BadgePiratesLLC/DefCon_SecKC_26/Tutorials/README.md

# Badge Pirates DC26 Badge Tutorials

Our badge (while blingy) is designed for hacking.  The add-on development board gives you access to the pins
of the ESP32 MCU as well as power.  The idea is for you to take and extend the badge to do something even more
interesting.
# How to Program the DC26 Badge
[Program SecKCDC26 Badge](/Tutorials/Programming/README.md)

## Examples

We are providing several tutorials and examples for different hacks that we have done using the badge.  These
should give you a good starting point to build on and make it yours!

### LiPo Battery Extension

The stock badge comes with a 2x AAA battery holder which will power the badge for about 8 hours of full
bling.  If you want to turn on the wireless features, it draws down the battery much quicker.  @fg has
done a hack to add a LiPo and charger to his badge to give you an idea of how to do this.

[LiPO Battery Tutorial](/Tutorials/Lipo/README.md)

### Cotcha Stand Alone Badge

Maybe you didn't buy a badge and got just a DEV board, or want to build a badge of your own.  @networkgeek took
the components from a SECKC Cotcha designed by @billswearingen and made a completely stand alone badge.

[SecKC Cotcha Tutorial](/Tutorials/Cotcha/README.md)

### SecKC the World Party Standalone

Were you one of the supporters for the very first (offical) [SecKC](www.seckc.org) Defcon Party?  There were some additional things
about the SAO that you might not have known.

[SecKC the World SAO](/Tutorials/SecKCSAO/README.md)

## Authors

* **networkgeek** - [Carl Fugate](www.twitter.com/carlfugate)
* **fg** - [Kevin Bennett](www.twitter.com/flightgod)

## License

This project is licensed under the MIT License - see the [LICENSE.md](LICENSE.md) file for details

## Acknowledgments

* CodexMafia for his second year in helping us put badges together
* Bill Swearingen for the AWESOME SECKC Cotcha
* The entire #badgelife team for their support in helping us to become fellow badgemakers
