BadgePiratesLLC/DefCon_SecKC_26/Coin/1.png

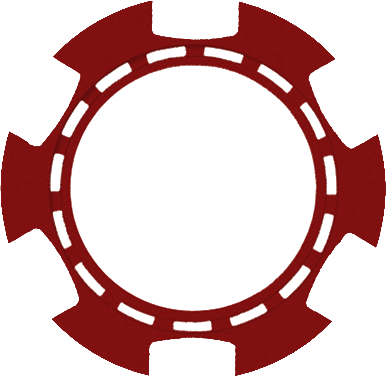
Coin/1.png
