BadgePiratesLLC/DefCon_SecKC_26/Coin/2.png

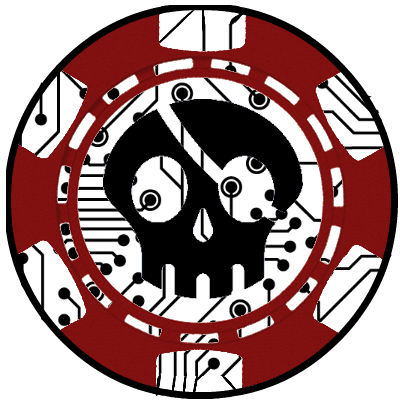
Coin/2.png
