BadgePiratesLLC/DefCon_SecKC_26/Coin/231RD.png

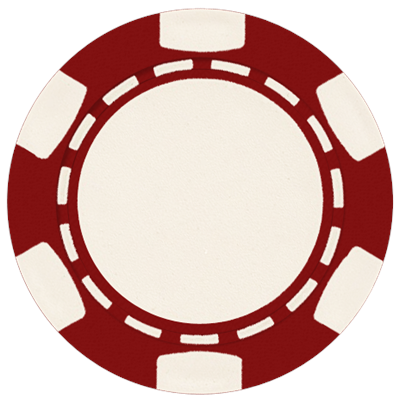
Coin/231RD.png
