BadgePiratesLLC/DefCon_SecKC_26/Coin/BP@DC.png

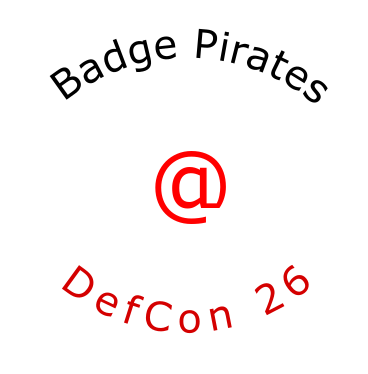
Coin/BP@DC.png
