BadgePiratesLLC/DefCon_SecKC_26/Coin/BPSkull_Black.png

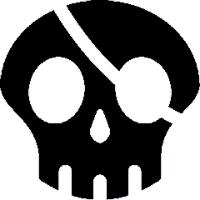
Coin/BPSkull_Black.png
