BadgePiratesLLC/DefCon_SecKC_26/Coin/chiop.png

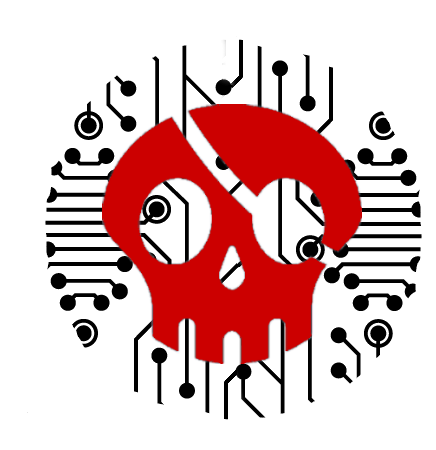
Coin/chiop.png
