BadgePiratesLLC/DefCon_SecKC_26/Coin/ChipGold.png

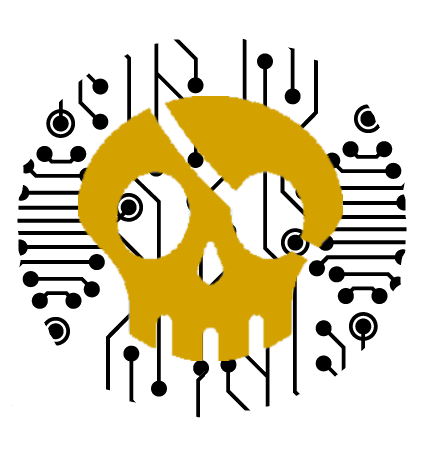
Coin/ChipGold.png
