BadgePiratesLLC/DefCon_SecKC_26/Coin/ChipGray.png

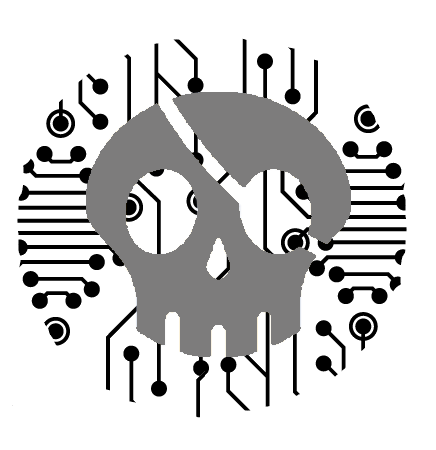
Coin/ChipGray.png
