BadgePiratesLLC/DefCon_SecKC_26/Coin/drawing-1.png

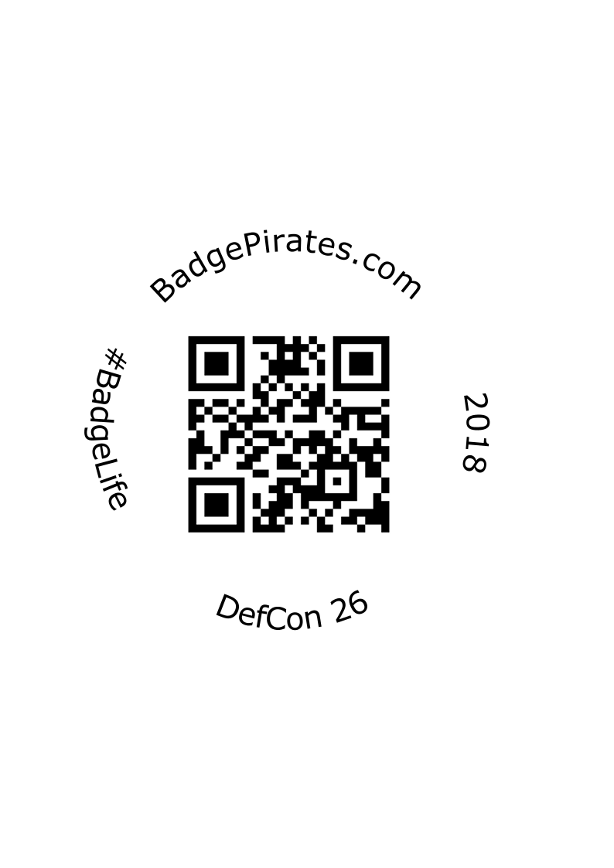
Coin/drawing-1.png
