BadgePiratesLLC/DefCon_SecKC_26/Coin/images.png

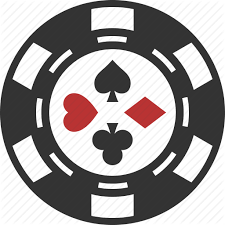
Coin/images.png
