BadgePiratesLLC/DefCon_SecKC_26/Coin/Outline1.png

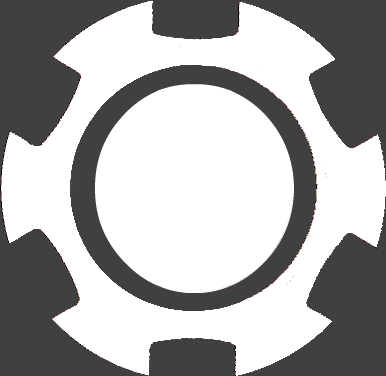
Coin/Outline1.png
