BadgePiratesLLC/DefCon_SecKC_26/Coin/Outline.png

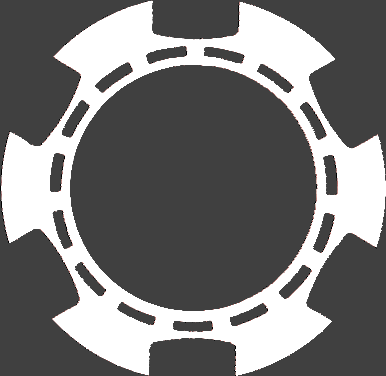
Coin/Outline.png
