BadgePiratesLLC/DefCon_SecKC_26/Coin/PCD01_Red.jpg

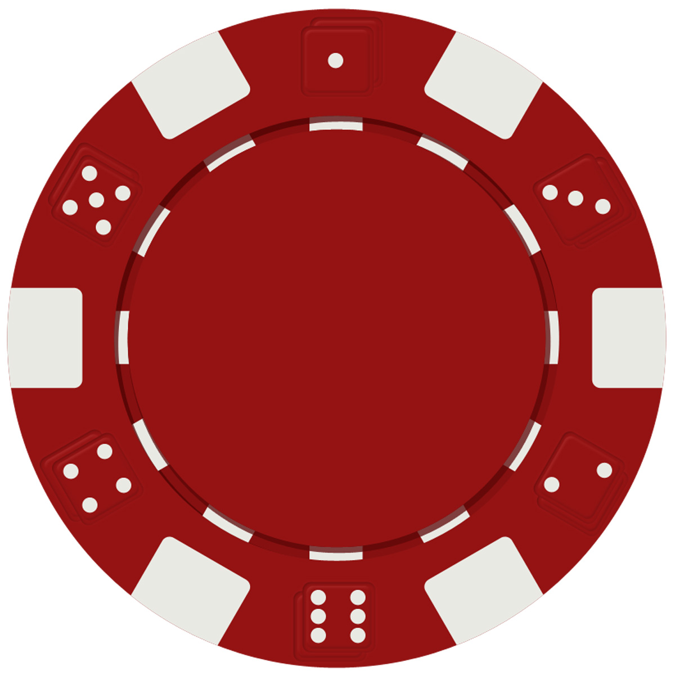
Coin/PCD01_Red.jpg
