BadgePiratesLLC/DefCon_SecKC_26/Coin/traces1.png

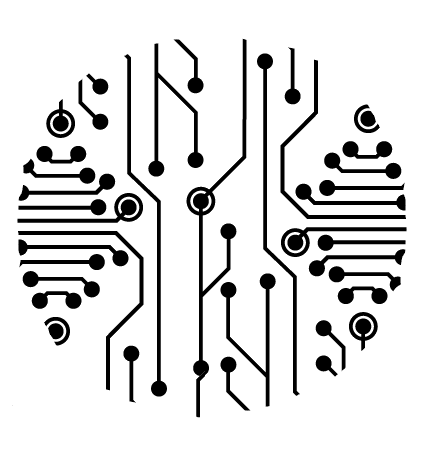
Coin/traces1.png
