BadgePiratesLLC/DefCon_SecKC_26/Coin/traces.png

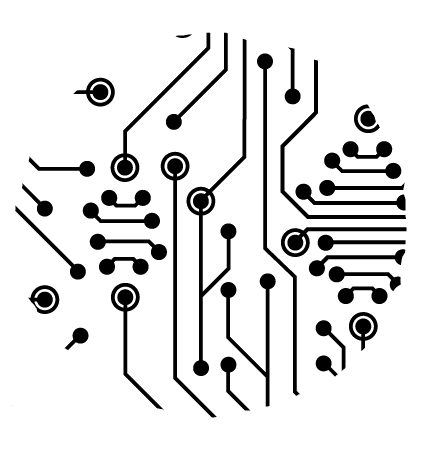
Coin/traces.png
