BadgePiratesLLC/DefCon_SecKC_26/Photos/Capture.JPG

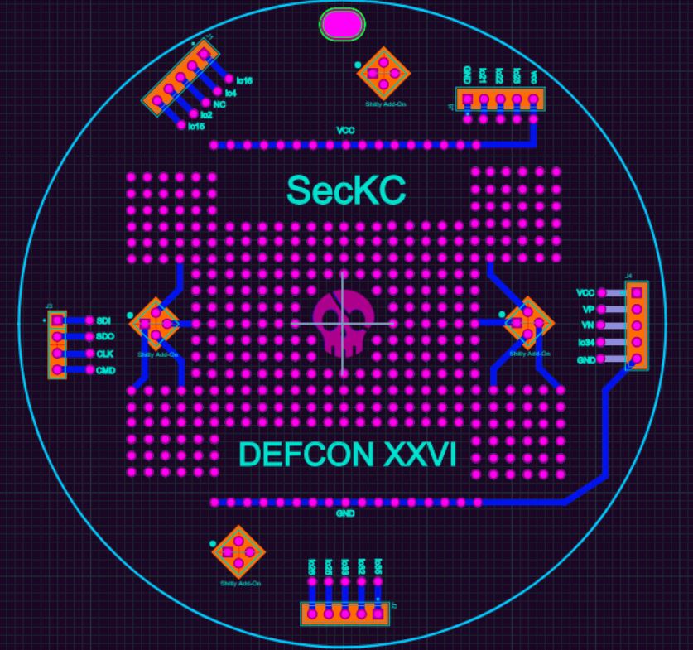
Photos/Capture.JPG
