BadgePiratesLLC/DefCon_SecKC_26/Photos/Capture.PNG

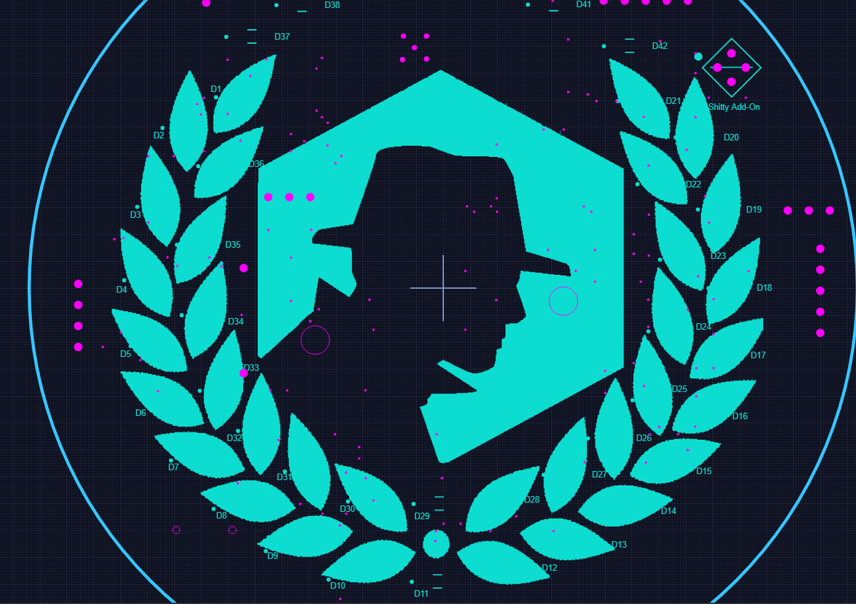
Photos/Capture.PNG
