BadgePiratesLLC/DefCon_SecKC_26/Photos/chipGold.png

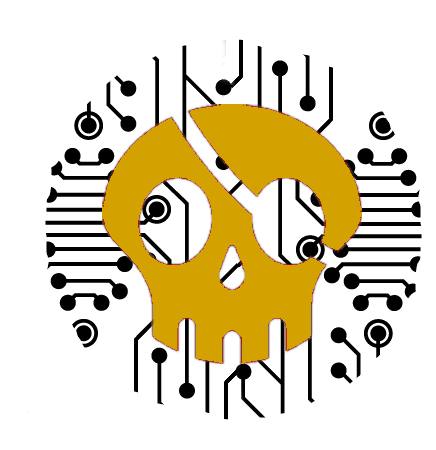
Photos/chipGold.png
