BadgePiratesLLC/DefCon_SecKC_26/Photos/IMG_3219.JPG

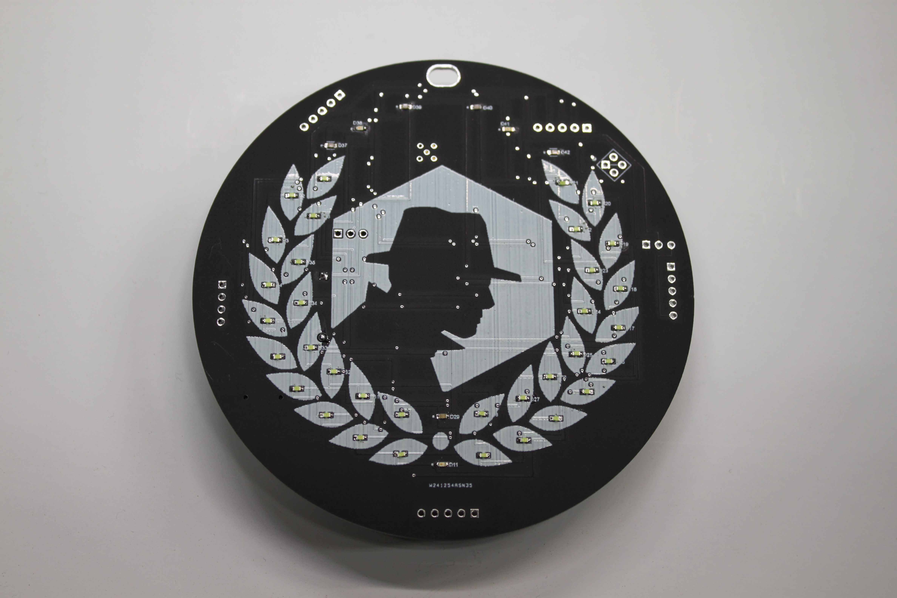
Photos/IMG_3219.JPG
