BadgePiratesLLC/DefCon_SecKC_26/Photos/SECKC Bob Shitty Addon.png

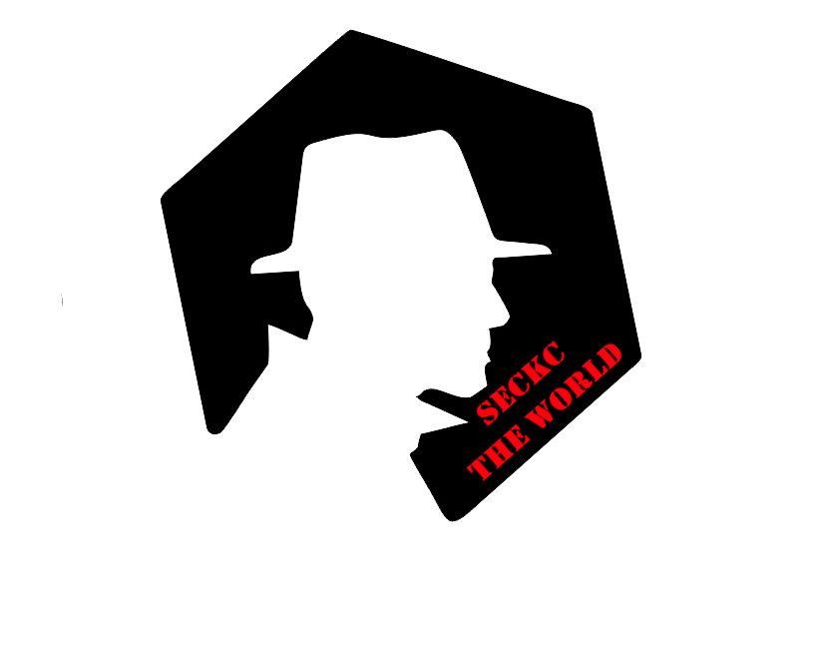
Photos/SECKC Bob Shitty Addon.png
