BadgePiratesLLC/DefCon_SecKC_26/Photos/SECKC Bob with wreath.png

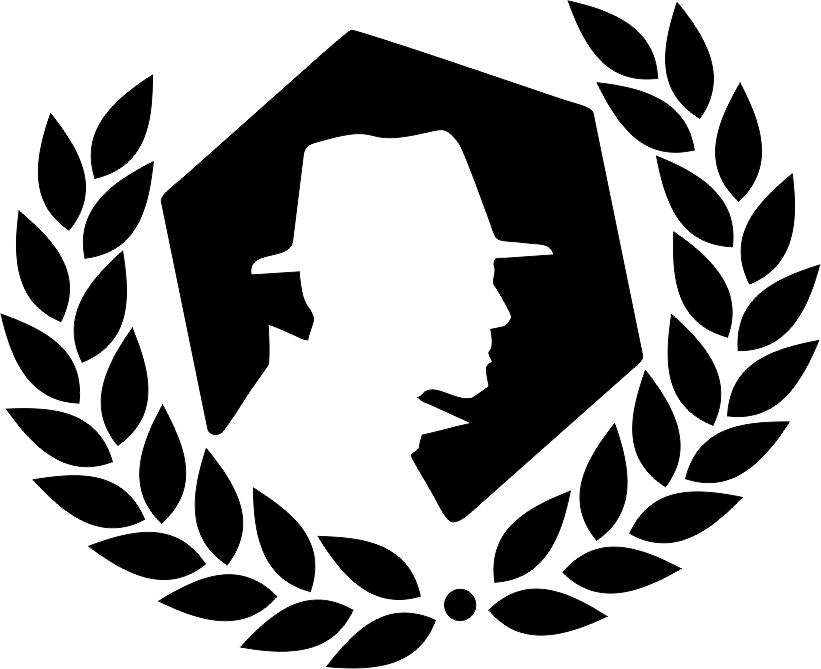
Photos/SECKC Bob with wreath.png
