BadgePiratesLLC/DefCon_SecKC_26/Photos/SECKC wreath.png

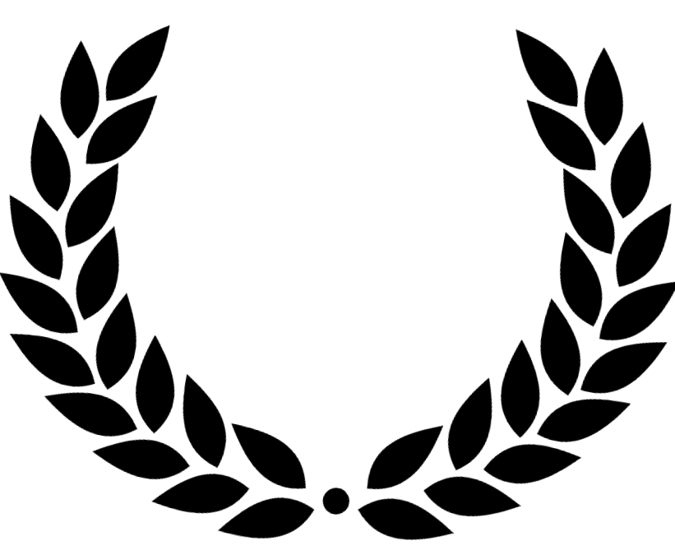
Photos/SECKC wreath.png
