BadgePiratesLLC/DefCon_SecKC_26/BadgePirates_SecKC_DC26Badge_BOM.xlsx

Reference Designator | Description | Manufacturer | Manufacturer Part Number | Package | Quantity | Mouser Part Number | Digikey Description | Digikey Part Number | URL | Price
2 AAA | PC BATTERY HOLDER (2) 'AAA' | Keystone | 2468 | BAT_HOLDER | 1 | 534-2468 | HOLDER BATTERY 2CELL AAA PC MNT | 36-2468-ND | https://www.digikey.com/en/products/detail/keystone-electronics/2468/303817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 | $1.29
Button 0 Reset | 6mm Tact Switch, Straight Termination, 160 grams actuation force | C&K | PTS645SM43SMTR92 LFS | SW_SMT_6MM0_6MM0_TACT | 2 | 611-PTS645SM43SMTR92 | Tactile Switch SPST-NO Top Actuated Surface Mount | CKN9112CT-ND | https://www.digikey.com/en/products/detail/c-k/PTS645SM43SMTR92-LFS/1146840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 | $0.30
C1 C11 | 0.1ÂµF Â±10% 10V Ceramic Capacitor X7R 0603 (1608 Metric) | Kemet | C0603C104K8RACTU | 603 | 2 | 80-C0603C104K8R | CAP CER 0.1UF 10V X7R 0603 | 399-1095-1-ND | https://www.digikey.com/en/products/detail/kemet/C0603C104K8RAC7867/411094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 | $0.11
C10 | 220ÂµF 6.3V Aluminum Electrolytic Capacitors Radial, Can - SMD 1000 Hrs @ 105Â°C | Panasonic | EEE-HA0J221WP | RADIAL | 1 | 667-EEE-HA0J221WP | CAP ALUM 220UF 20% 6.3V SMD | PCE4161CT-ND | https://www.digikey.com/en/products/detail/panasonic-electronic-components/EEE-HA0J221WP/814133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 | $0.45
D1 D10 D12 D13 D14 D15 D16 D17 D18 D19 D2 D20 D21 D22 D23 D24 D25 D26 D27 D28 D3 D30 D31 D32 D33 D34 D35 D36 D4 D5 D6 D7 D8 D9 | SML-E1 SERIES | ROHM | SMLE12WBC7W1 | 603 | 34 | 755-SMLE12WBC7W1 | LED WHITE DIFFUSED 0603 SMD | 511-1602-2-ND | https://www.digikey.com/en/products/detail/rohm-semiconductor/SMLEN3WBC8W1/9448228 | $0.52
D11 D38 D41 | Blue 470nm LED Indication - Discrete 2.8V 0603 (1608 Metric) | Lite-On Inc. | LTST-C193TBKT-5A | 603 | 3 | 859-LTSTC193TBKT5A | LED BLUE CLEAR 0603 SMD | 160-1827-1-ND | https://www.digikey.com/en/products/detail/liteon/LTST-C193TBKT-5A/2053656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 | $0.28
D29 D39 D40 | EXCELEDâ„¢ series chip LED | ROHM | SML-D12V8WT86 | 0603 (1608 metric) | 3 | 755-SML-D12V8WT86 | LED RED DIFFUSED 0603 SMD | 511-1581-1-ND | https://www.digikey.com/en/products/detail/rohm-semiconductor/SML-D12V8WT86/1641800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 | $0.36
D37 D42 | Standard LEDs - SMD SMD Yellow/Green 10-63 mcd | ROHM | SML-D12M8WT86 | 0603 (1608 metric) | 2 | 755-SML-D12M8WT86 | LED GREEN DIFFUSED 0603 SMD | 511-1578-1-ND | https://www.digikey.com/en/products/detail/rohm-semiconductor/SML-D12M8WT86/1641797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 | $0.32
Power | Sub-Miniature Slide Switch - RIGHT ANGLE SURFACE MOUNT SPDT | C&K | JS102011SAQN | SMT_SWITCH_9MM_3.6MM | 1 | 611-JS102011SAQN | Slide Switch SPDT Surface Mount, Right Angle | 401-1999-1-ND | https://www.digikey.com/en/products/detail/c-k/JS102011SAQN/1640095?s=N4IgTCBcDaICwAYCMBaJBOTaUDkAiIAugL5A | $0.71
R1 R2 R3 R4 R5 R6 R7 | GENERAL PURPOSE CHIP RESISTORS | YAGEO | RC1206JR-07220RL | 1206 (3216 metric) | 7 | 603-RC1206JR-07220RL | RES SMD 220 OHM 5% 1/4W 1206 | 311-220ERCT-ND | https://www.digikey.com/en/products/detail/yageo/RC1206JR-07220RL/729251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 | $0.10
R18 | GENERAL PURPOSE CHIP RESISTORS | YAGEO | RC0603FR-0710KL | 603 | 1 | 603-RC0603FR-0710KL | RES SMD 10K OHM 1% 1/10W 0603 | 311-10.0KHRCT-ND | https://www.digikey.com/en/products/detail/yageo/RC0603FR-0710KL/726880 | $0.10
U112 | WIFI module | Espressif | ESP-WROOM-32 | MOD_SMT | 1 | 485-3320 | SPRESSIF ESP32 BLUETOOTH WIFI M | 1188-1178-ND | https://www.mouser.com/ProductDetail/Adafruit/3320?qs=JnzaLlyswt4EqYFFVW2Law%3D%3D | $7.83
