BadgePiratesLLC/DefCon_SecKC_26/(list of files, cad)

Other CAD files:
Coin/BPSkull_Black.dxf
