BadgePiratesLLC/DefCon_SecKC_26/Tutorials/Programming/README.md

In Arduino I add to Library for the 8266

•	Open Arduino go to file preferences and enter this URL in the “Additional Boards manager” Field

•	http://arduino.esp8266.com/stable/package_esp8266com_index.json

The SecKC DC26 Badge uses the Badge Battery for Programming. Ensure the Battery is connected

Connect FTDI to Pins Tx, Rx, and Ground

Use Jumper to ground out io0 with ground

Turn Badge On

Push to Code
