BadgePiratesLLC/DefCon_SecKC_26/Gerbers/Project-Moe-Schematic--Final.pdf

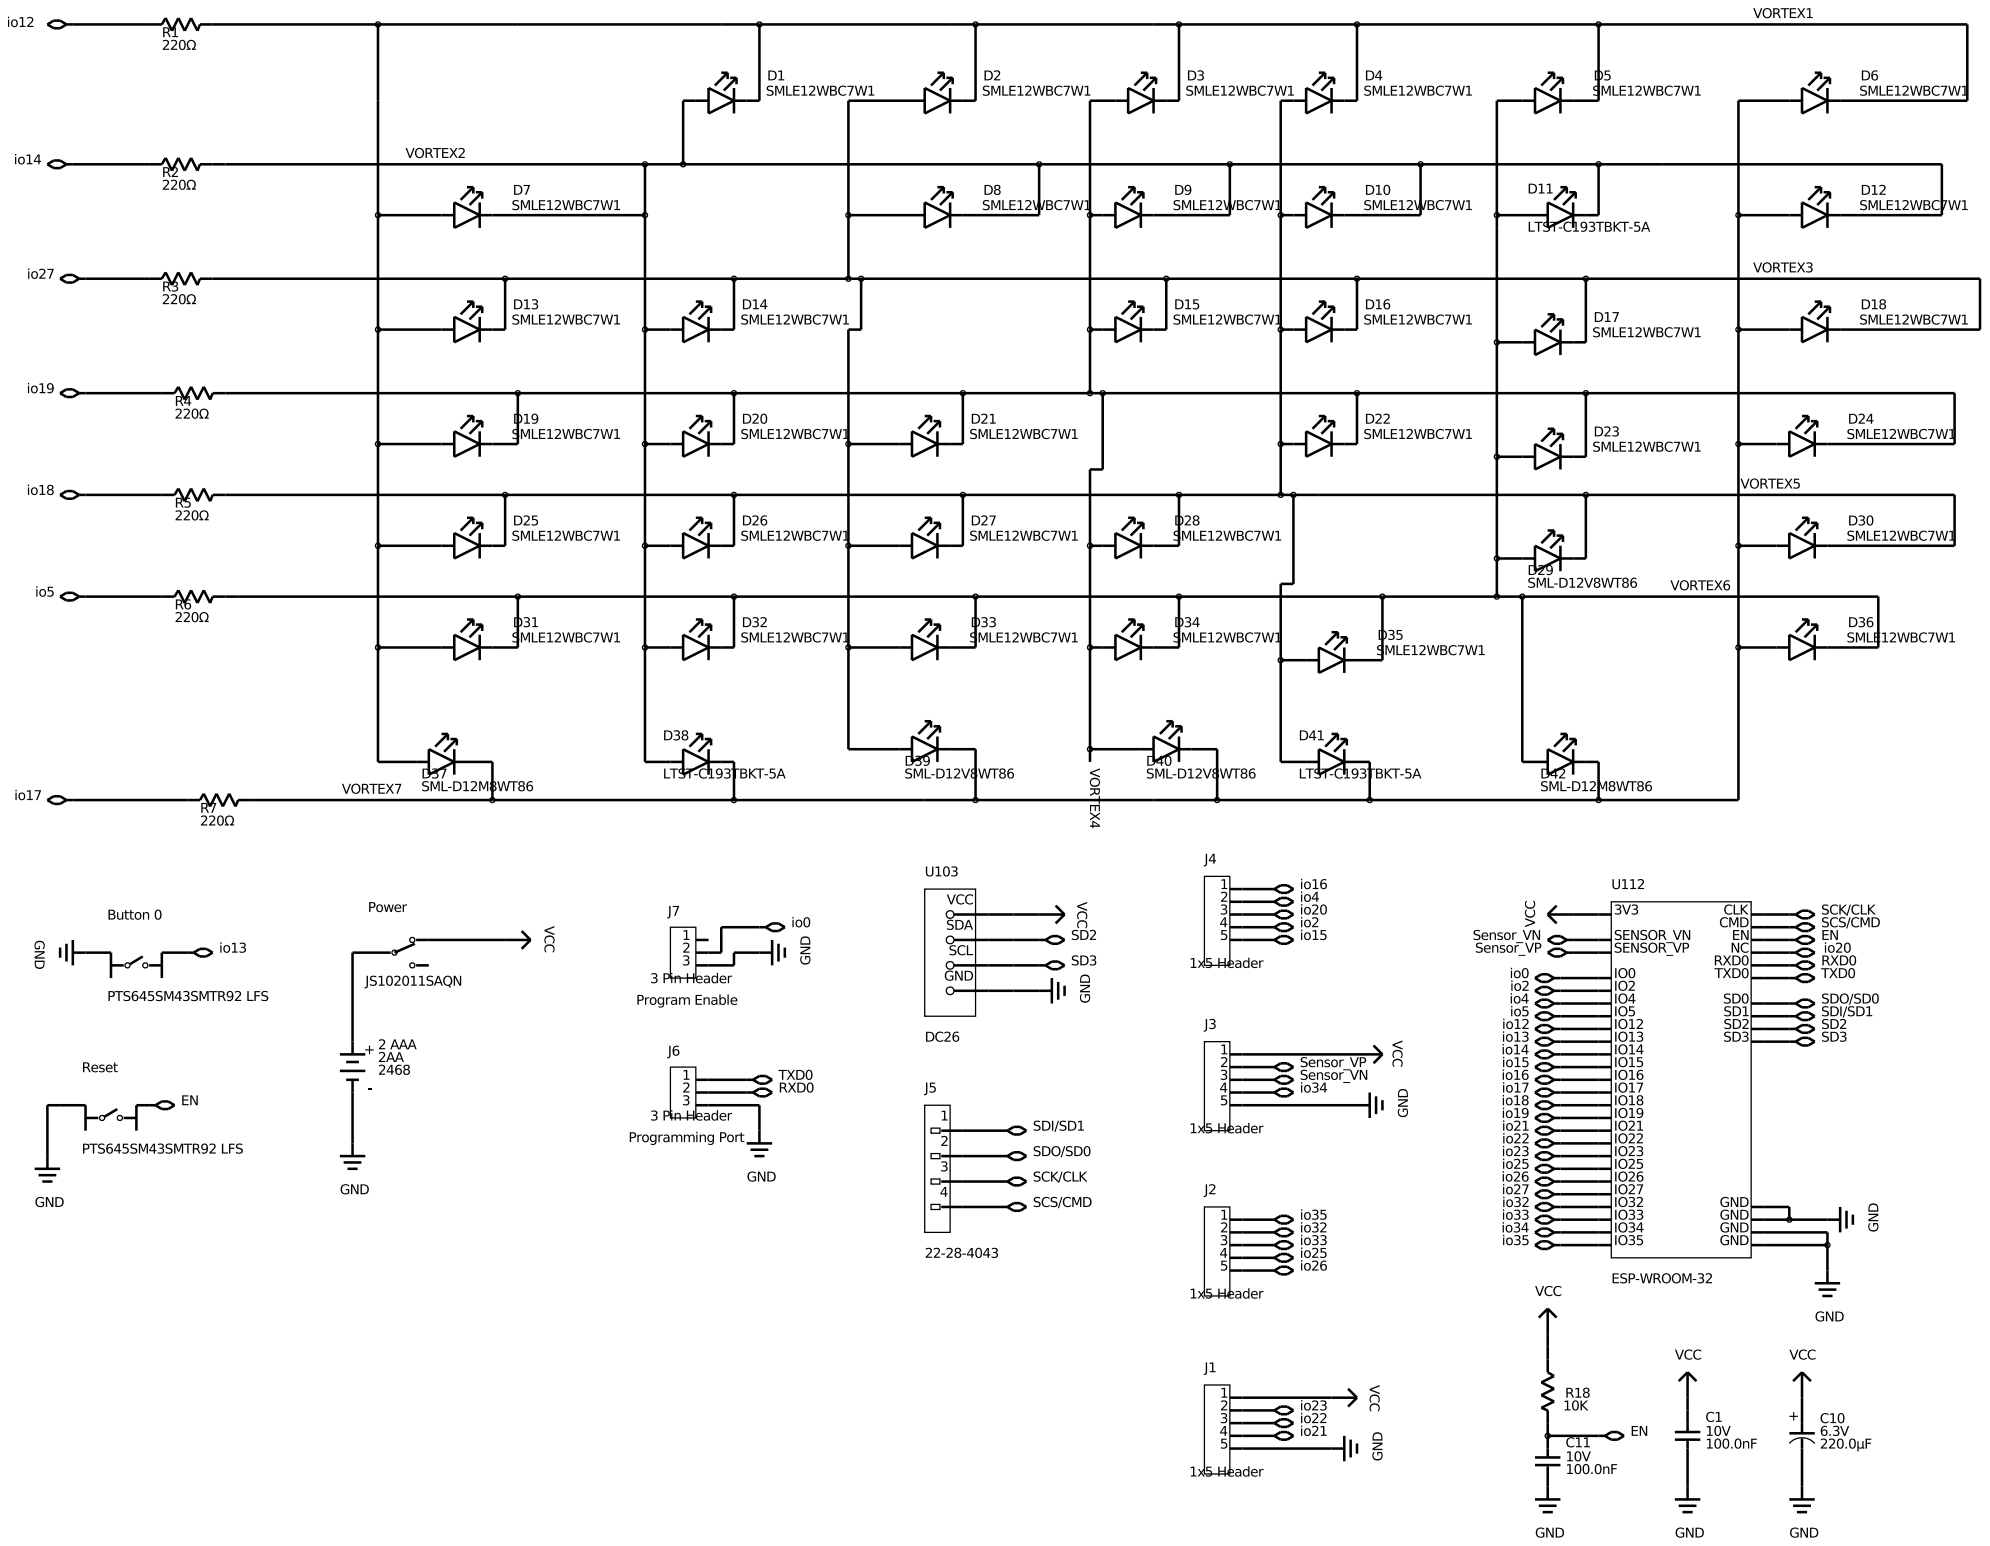
[picture p34: page 1]
