BadgePiratesLLC/DefCon_SecKC_26/(commit log)

2018-06-07 Updating will all the files after submitting
    [BPSkull_Black.dxf, Project-Moe-BOM--Final.csv, Project-Moe-Drill Chart--Final.csv, SecKCDC26_PriceSheet.xlsx]
2018-06-07 Removing the price sheet worksheet, not for public consumption
    [SecKCDC26_PriceSheet.xlsx]
2018-08-02 Added Lipo tutorial
2018-08-03 Updated Cotcha Tutorial to include images and made minor updates to LiPo tutorial
2018-08-03 Updated Tutorials readme links to Lipo and Cotcha
2023-12-17 BOM Uploaded with Links
    This is best effort as some of the parts are EOL and harder to find. But there is enough information to be able to track them down.
    [BadgePirates_SecKC_DC26Badge_BOM.xlsx]
